stuffcube/etereo_plotter_verticale/(list of files, drawings)

Other design files:
plotterVertical_01.fzz
